trevorpeacock/ChristmasTree/(threads)

Thread 1 (2020-11-25):

Missing Information ?

Legsmaniac, 2020-11-25:
I've been looking for something like this and came across this via a search.  Very interesting.
Almost what I was looking for, I feel I could modify to suit my own needs.
However.....
There doesn't seem to be any information on how the star is wired up.
I can see how it's constructed from the video, photos and sketch but in what order are the various strips connected DIN and DOUT?
If I have missed this, apologies, otherwise could you possibly include this information?
Thanks.

trevorpeacock, 2020-11-26:
You're correct, the star was a later addition, I haven't updated the documentation.

Its just a continuation of the WS2811B string, DOUT always connects to DIN on the next strip. The star is simply connected to the last DOUT on the tree.

Power needs to be injected somewhere, We've probably just done it at the start of the star.

I think this is the order they're connected (excuse the crude drawing)

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

[Common.h#L14](https://github.com/trevorpeacock/ChristmasTree/blob/4bb41e0dd29edc903838218716613ec9de1dbae8/LED/Common.h#L14) specifies there are 5 points on the star, 5 leds on each edge, 3 leds on each side of the internal pentagon, and two stars in the middle (suspended on thin wires, one pointing forwards, one backwards). You can adjust these numbers to scale up/down the size of the star. The whole thing is constructed with large paddle-pop sticks, and tissue paper. Though I expect you'll find your own solution based on what you have on hand.

[LED/LedCalculations.h#L41](https://github.com/trevorpeacock/ChristmasTree/blob/4bb41e0dd29edc903838218716613ec9de1dbae8/LED/LedCalculations.h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) defines how to address the leds. Section 0 is the centre leds, section 1 the inner pentagon, section 2 the outer star. When addressing the centre leds (section=0) pos 0 and 1 select the forward or backward LED. When addressing the core pentagon (section=1) point selects the edge(0-4), pos (0-2) selects the led position on that edge. When addressing the outer star (section=2), point selects each edge (0-9) and pos selects the led on the edge (0-4)

If you did happen to arrange your LEDs differently, you could update the `starid` function to match your layout.

Hope that makes enough sense, and gets you started. Let me know if theres any more you need. Please let me know what you make, I'd love to see it.

Legsmaniac, 2020-11-26:
Thank you so much for your reply.
And for the main tree body I'm guessing it's bottom, top, bottom, top (etc) - starting bottom and ending top?
Or is it bottom, top, top, bottom (etc) ?

Deffo want to give this a try. As I said, I have a few ideas of my own but whether I'll get around to doing it for this Christmas 2020 now, I'm not sure but deffo Christmas 2021 for sure.
Sure, I'll pop back and post a photo of my finished design at some point.
Many thanks again for the info.
All the best and take care.

trevorpeacock, 2020-11-26:
We did start (and with an even number of rows, end) the led strip at the bottom of the tree. However, again, you can change that mapping my modifying [`ledid`](https://github.com/trevorpeacock/ChristmasTree/blob/4bb41e0dd29edc903838218716613ec9de1dbae8/LED/LedCalculations.h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) and [`ledidC`](https://github.com/trevorpeacock/ChristmasTree/blob/4bb41e0dd29edc903838218716613ec9de1dbae8/LED/LedCalculations.h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). All of the patterns should be using those functions to convert from led row & high to the actual led position in the WS2811B string.

Should be doable as a weekend project if you have everything on hand. Two of us got the original tree built in about 10h (the star and sound sensor were later additions), tinkered over a week writing code.

I'm very tempted to get some PCBs made to connect the LED strips, and provide a strong mechanical support for attaching them top and bottom, as the sticky tape solution, while quick to implement, is a mess to put up/tear down every year. Haven't thought too seriously about it. If you're interested and have any ideas let me know.

PS. you'll probably want to [turn off](https://github.com/trevorpeacock/ChristmasTree/blob/4bb41e0dd29edc903838218716613ec9de1dbae8/LED/Common.h#L7) the sound & light sensor if you're not adding those in your build. I need to do a much better job of documenting the code, feel free to keep asking questions, I'll try to document any hard to read bits as I have time.

Legsmaniac, 2020-11-27:
I have another project where I have attached WS2812B LED strips to springy curtain rods.  (The kind designed to go inside window frames for nets etc. Rubber on each end provides quick set and release.)  On each end of the strips I have soldered JST SM 3 Pin Plug/Sockets so that I can connect strips together.  I'm presently thinking of using the same plugs/sockets for this project but instead of curtain rods, I'm thinking either small round wooden dowels or flat wood strips.  Currently, I don't own a 3D Printer but I am getting one for Xmas this year from my beloved wife.   I see no reason why some kind of plastic strips couldn't be printed for support rails.  We'll see but I'm keen on the wood idea as I love working with wood any how.

I haven't yet decided whether I will cover it and with what if I do but my current thoughts are to leave uncovered, providing the finished assembled article looks neat.

You are correct, I personally have no need for the sound and light sensors.  All being well, I hope to strip them out of the code.  If I fail with that then yeah, I'll just leave them turned off and no hardware connected.   I'm no expert but I have been playing with Arduino and coding for a while now as a hobbyist and with the help of Google, Github and people like yourself, I am able to seek help and code snippets to put my own routines and sketches together.  Earlier this year, I built a Christmas Tree out of wood with holes in which mounted within are 12 bells with solendoids built into them.  I then created a sketch from scratch to play Christmas tunes on the bells.  I then expanded it, adding more routines and hardware so that you could use buttons to select required tunes on an LCD Display, then added IR Remote tune selection, then went braver still with BlueTooth tune selection via an Android app I also created with the help of MIT AppInventor - and some.  It's been quite an achievement for me and one I'm quite proud of.  And it didn't stop there.  I then added some WS2812b strips to the tree and added a star, also with LED strips.  I then added a second Arduino running Christian Schwinne's famous WLED ( @Aircoookie ) slightly modified so that it plays different light effects for each selected Christmas Musical Bells Tune.

Anyway, enough bragging!  LOL  🤣

I'm sure it could be created in a weekend but when you're a fussy perfectionist like me, who loves working with wood and wants to make something pleasing to the eye without a cover, then it's probably a bit more than a weekend.  In any case, I also have heaps of other stuff to do as well as finish Xmas shopping, present wrapping, delivering (if I can!  Boris is causing us problems with his Tier 3 Lockdown ideas!) and goodness knows what else.  Anyway, if it's a job worth doing, it's worth doing well.  😉
If you do find the time to document this and perhaps add REM Comments within, that would be great but with Christmas just around the corner, I wouldn't expect you to.

Many thanks again and all the best.
PS
Sorry for hogging the Issues section.  Perhaps this would have been better via email.  😊

trevorpeacock, 2020-11-29:
Thanks for sharing, I don't often get the chance to hear about others projects. As a musician I love the bells project idea.. so tempting to try that myself

I didn't have any at the time, but you can get connectors for LED strip (2,3,4 pin varieties, as well as joiners, right angles etc)
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
I'm looking for something that will provide mechanical mounting as well as electrical. Something that will grip the LED strip somehow (to not stress the connections), and will provide a mounting point for the tree scaffold.

The main purpose of the cover is to diffuse the light, it actually makes it easier to see, and easier on the eye. Anything translucent, held a few cm away from the leds. Without the diffuser I'd want a greater density of LEDs (144 led/m strips, more strips, closer together). Would probably need a faster processor to run that though, and probably more RAM. I have a box of STM/ARM Cortex development boards I haven't had time to experiment with.

The light sensor means the tree will match its brightness to the ambient light. We have lots of windows, in daylight it will be visible, but won't be too bright at night with overhead lighting. The sound sensor also lets us just leave it on, it will turn the leds off if its silent. Convenient, but not essential.

I haven't used `ifdef` blocks, but I think the compiler should optimize out the sound/light code if you set `SOUND_SENSOR` and `LIGHT_SENSOR` false. So no penalty for not removing the code.

3d printers are great (and i now have three) but I still believe you're better off using other solutions if feasible (I'd have got a laser cutter or CNC router instead if I had the space). Only if it can't easily be fashioned from plastic/wood/metal, then go for 3d printing. 3D printers are imprecise, unreliable, and slow. But they do let you make parts you couldn't any other way.

I also totally understand the perfectionist mindset. For me this project was very much in the "just get it done or it will never be done" category. As I recall I had had the parts on hand for 6 weeks, but it wasn't until the day before Christmas that work had quietened down enough that i could take a few hours off to get started.

If I have time I will better document the code, now I look at it a few years later I realise how rushed it was. If theres any specific parts you're having trouble with feel free to open a specific issue to hurry me along for that section.

Sorry to hear about your lockdown, we've had similarly harsh restrictions here. Thankfully here they've been very successful and we're recovering some normality. Hope you stay safe.

Legsmaniac, 2020-11-29:
Never tried attaching photos to this before - here goes......
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
Just a couple of naff photos to show you my musical bells tree.

I've used those clips in the past.  I find them mostly totally unreliable as do many other people I know.  Most people often end up soldering the clips to the pads to ensure a good connection which defeats the purpose of using them and then of course they're permanent.  Hence I now prefer the plugs/sockets.
I'm pretty sure using those clips for this idea will, over time, weaken and snap and in any case, they will be a pig to open and close.  Especially if you're talking 16 strips or more, that's 32 clips, or more!  Not for me, ta.

Yes, I realise the purpose of the cover as well as aesthetic looks but my thinking is, we don't chuck a cover over our christmas trees once we've added the string of 320 lights, do we?  I Googled for a few ideas and these are some examples of some I'd like to attempt.  The first one being similar to this project - see what I mean without a cover?  😉  Each to their own though, of course.
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
Not too sure about this last one, it's kinda boring I think, LOL

Yes, you said it - space.  Like you, if I had the space, I'd have a CNC Router, Laser Cutter, Lathe, the lot!  Actually, I had a laser cutter for a short while, quite an expensive powerful one and I was shocked at it's size when it arrived.  I did have a go with it before I decided to send it back and the smell and smoke filling the room was another problem!  You really need an outside workshop for machines like these and this is the reason why I don't have a CNC Router already, plus the mess these woodworking tools leave!  Hmmmmmm.   Maybe in another life.  Or if I won the lottery.
The 3D printer I have coming will only create a maximum volume size of 140mm cubed to keep the overall size of the machine down because of - yes, there we go again - space.  Or lack thereof.  So I'll be a tad limited in what things I can create without designing interlocking parts whereupon I can go bigger.  We'll see.  Plus, there's less/little/no waste/smell/smoke so I'm happy with that.

Onwards and upwards......
