trevorpeacock/ChristmasTree/Sensor/Sensors.sch

## KiCad design Sensor/Sensors.sch (2018-12-22)

Schematic: Sensors.sch

Parts:
C1: 100uF
C2, C3: 20pF
C4: 100nF
MK1: Electret Microphone
R1: R_PHOTO
R2, R3, R5, R6, R9, R10: 10k
R4, R8: 1k
R7: 100k
RV1: 10K_POT
U1: ATmega328P-PU; DIP-28_W7.62mm
U2: LM324
Y1: 16MHz
