trevorpeacock/ChristmasTree/(commit log)

2017-01-01 Add documentation
    LTspice schematic and code comments
2017-01-02 Add power supply load test
2018-12-14 make sensors switchable. improve reliability of communication
2018-12-22 update documentation
    [Sensors.sch]
2018-12-24 Update Sensor.ino
    Fix Typo
    [Sensor.ino]
2018-12-24 Update Common.h
    fix timin logic
    [Common.h]
2018-12-24 Update Sensor.ino
    break listening into seperate function
2018-12-24 use correct data types for timing
    [Common.h, Sensor.ino]
2018-12-24 brinf WaitFor from LED library for consistency
2018-12-29 fix patterns incorrectly displaying star
    [Common.h, Patterns.h, UtilityPatterns.h]
2018-12-29 fix star in loudness pattern
    [Patterns.h]
